soldernerd/UltrasonicAnemometerHardware/StandaloneAnemometer_RevA_BOM.xlsx

Qty | Value | Device | Package | Parts | Description | MF | MPN | OC_FARNELL | OC_NEWARK | Manufacturer | Model | Farnell | Unit Price | Price | Manufacturer | Model | Farnell | Unit Price
1 |  | LED0805 | LED0805 | LED1 | LED |  |  |  |  | Kingbright | KP-2012SECK | 2290332 | 0.115 | 0.115
19 | 100n | CC0805 | C0805 | C5, C6, C7, C8, C9, C10, C11, C12, C13, C14, C15, C16, C20, C21, C22, C23, C24, C25, C26 | Capacitor |  |  |  |  | Multicomp | MC0805B104K500CT | 1759265 | 0.0146 | 0.2774
28 | 10k | RESISTORR0805 | R0805 | R2, R3, R4, R5, R6, R7, R8, R9, R10, R11, R12, R13, R14, R15, R16, R17, R18, R19, R20, R22, R23, R24, R25, R26, R27, R28, R29, R30 | RESISTOR, European symbol |  |  |  |  | Multicomp | MC01W0805110K | 9332391 | 0.0018 | 0.0504
2 | 10p | CC0805 | C0805 | C17, C18 | Capacitor |  |  |  |  |  |  |  | 0.06 | 0.12
4 | 10u 6V3 | CC0805 | C0805 | C2, C3, C4, C19 | Capacitor |  |  |  |  |  |  |  | 0.07 | 0.28
1 | 1k | RESISTORR0805 | R0805 | R21 | RESISTOR, European symbol |  |  |  |  | Multicomp | MC01W080511K | 9332383 | 0.0022 | 0.0022
1 | 330 | RESISTORR0805 | R0805 | R1 | RESISTOR, European symbol |  |  |  |  |  |  |  | 0.02 | 0.02
1 | 33u 16V | C_POLARIZEDSMC_B | SMC_B | C1 |  |  |  |  |  | AVX | TPSB336K016R0350 | 1658966 | 0.673 | 0.673
2 | 74HC4052SO | 74HC4052SO | SO16 | IC1, IC2 |  |  |  |  |  | NXP | 74HC4052D | 1201328 | 0.397 | 0.794
1 | 8MHz | CRYSTAL_SHIELDED | 5X3.2MM | XTAL1 | Shielded Crystal |  |  |  |  | Abracon | ABM3B-8.000MHZ-10-1UT | 2467816 | 0.85 | 0.85 | Abracon | ABM3-8.000MHZ-D2Y-T | 2101329 | 0.527
4 | BSS308PE | P-FET | SOT23 | Q2, Q3, Q4, Q5 |  |  |  |  |  | Infineon | BSS308PE H6327 | 2432719 | 0.1708 | 0.6832
1 | I2C1 | 22-23-2031 | 22-23-2031 | X6 | .100 (2.54mm) Center Header - 3 Pin" | MOLEX | 22-23-2031 | 1462950 | 30C0862
1 | I2C2 | 22-23-2031 | 22-23-2031 | X9 | .100 (2.54mm) Center Header - 3 Pin" | MOLEX | 22-23-2031 | 1462950 | 30C0862
1 | ICSP | 22-23-2051 | 22-23-2051 | X3 | .100 (2.54mm) Center Header - 5 Pin" | MOLEX | 22-23-2051 | 1462952 | 38C9178 |  |  |  | 0.2 | 0.2
1 | Input | 22-23-20411MM | 22-23-2041 | X5 | .100 (2.54mm) Center Header - 4 Pin"
2 | LM5111-2M | LM5111 | SOIC8 | IC3, IC7 | Dual 5A Compound Gate Driver |  |  |  |  | Texas Instruments | LM5111-2M/NOPB | 1685382 | 1.35 | 2.7
1 | LMC6482 | LMC6482 | SOIC8 | IC8 | CMOS Dual Rail-to-Rail Input and Output Operational Amplifier |  |  |  |  | Texas Instruments | LMC6482IM/NOPB | 1468889 | 1.75 | 1.75
1 | MCP1755 | MCP1755 | SOT-23-5 | IC9 |  |  |  |  |  | Microchip | MCP1755T-3302E/OT | 2361992 | 0.52 | 0.52
1 | MCP4561 | MCP4561MSOP | MSOP | IC10 | Digital POT |  |  |  |  | Microchip | MCP4561-103E/MS | 1698948 | 1.02 | 1.02 | Microchip | MCP4531-103E/MS | 1698946 | 0.591
1 | MCP6561R | MCP6561R | SOT-23-5 | IC6 | 1.8V Low-Power Push-Pull Output Comparator |  |  |  |  | Microchip | MCP6561RT-E/OT | 1834857 | 0.496 | 0.496
1 | Output | 22-23-20411MM | 22-23-2041 | X8 | .100 (2.54mm) Center Header - 4 Pin"
1 | PIC32MX2XX | PIC32MX2XX | SO28W | IC5 |  |  |  |  |  | Microchip | PIC32MX250F128B-I/SO | 2097772 | 3.69 | 3.69
1 | Power | 22-23-2021100MIL | 22-23-2021 | X1 | .100 (2.54mm) Center Header - 2 Pin" | MOLEX | 22-23-2021 | 1462926 | 25C3832
1 | SPI | 22-23-2061 | 22-23-2061 | X2 | .100 (2.54mm) Center Header - 6 Pin" | MOLEX | 22-23-2061 | 1462922 | 27C1933
1 | TCM829 | TCM829 | SOT-23-5 | IC4 |  |  |  |  |  | Microchip | TCM829ECT713 | 1840937 | 0.353 | 0.353
1 | Transducers | CON_8X3.5MM | 3.5MM_8X | CON1 | 8-pin header |  |  |  |  |  |  |  |  | 0
1 | USB | 22-23-20411MM | 22-23-2041 | X7 | .100 (2.54mm) Center Header - 4 Pin"
1 | USB_BMULTICOMP | USB_BMULTICOMP | USB_B | X4 | Type B USB connector |  |  |  |  | Multicomp | USB-B-S-RA | 2112373 | 0.566 | 0.566
1 | Board |  |  |  |  |  |  |  |  |  |  |  | 3.75 | 3.75
4 | Transducers |  |  |  |  |  |  |  |  | Multicomp | MCUSD16A40S12RO | 2362677 | 3.75 | 15
 |  |  |  |  |  |  |  |  |  |  |  |  |  | 33.9102
 |  |  |  |  |  |  |  |  |  |  |  |  |  | 36.85891304
