soldernerd/UltrasonicAnemometerHardware/(threads)

Thread 1 (2018-05-29):

Use CADLAB.io to render EAGLE files and diffs online

renne, 2018-05-29:
[CADLAB.io](https://cadlab.io/) is a service which renders EAGLE files and diffs online. This allows to show different stages of circuit/PCB development and improves community-based development.

I suggest to use [CADLAB.io](https://cadlab.io/) for rendering but stay with GitHub for versioning (forks, pull requests, etc.).
