soldernerd/UltrasonicAnemometerHardware/StandaloneAnemometer_RevB_Board.pdf

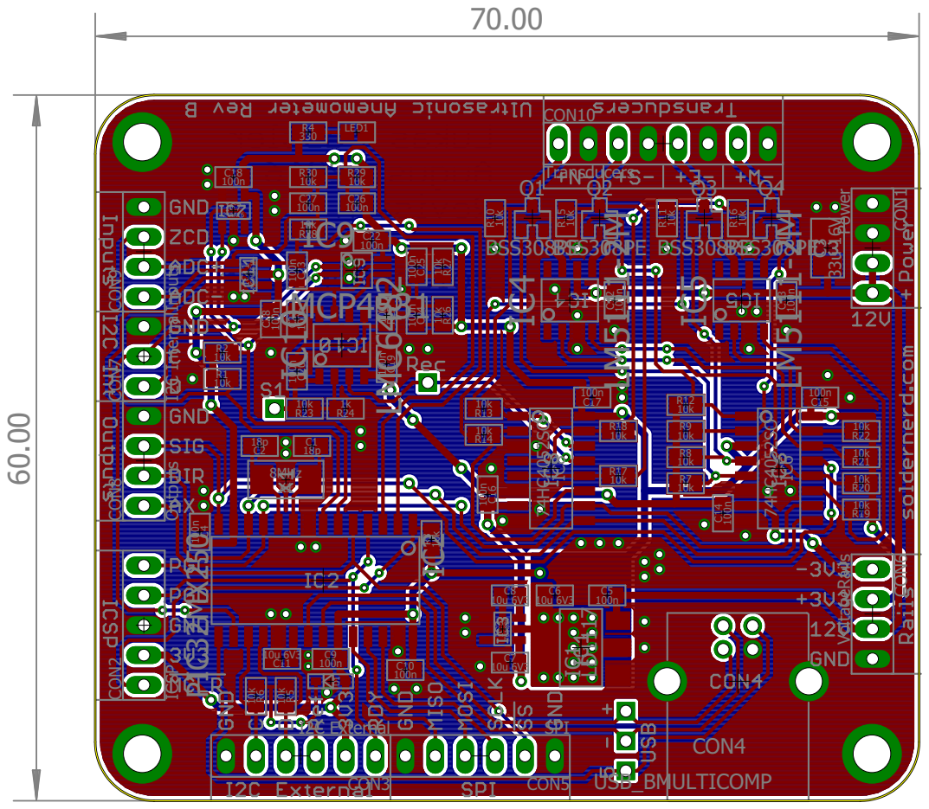
[picture p1: page 1]

IC6 IC4 C3 C8 C6 C7 R4 LED1 C4 C15 C14 IC8 C17 C16 R19 R20 R21 R22 R7R8R9 R12 C12 Q1 Q2 R10 R13 R15 R17 IC5C13 Q3 Q4 R11 R14 R16 R18 IC10 C19 C21 CON10 IC3 CON4 IC R23 C1 C2 C11 C10 C9 R2R1 IC11 R6R5 R23 R24 C22 C25 R26 R27 C24 C20 C27 R30 R29 C26 R25 C28 R28C23 X1 D1IC1 IC7 C18 IC9 C5 CON1 CON9 CON8 CON6 CON7 CON2 CON3 CON5 70.00 60.00 74HC4052SO LM5111-2M 33u 16V 10u 6V3 10u 6V3 10u 6V3 330 100n 100n 100n 74HC4052SO 100n 100n 10k 10k 10k 10k 10k 10k 10k 10k 100n BSS308BPSES308PE 10k 10k 10k 10k LM5111-2M 100n BSS308BPSES308PE 10k 10k 10k 10k LMC6482 100n 100n Transducers TCM829 USB_BMULTICOMP PIC32MX25010k 18p 18p10u 6V3 100n 100n 10k 10k MCP6561R 10k 10k 10k 1k 100n 100n 10k 10k 100n 100n 100n 10k 10k 100n 10k 100n 10k 100n 8MHz LD1117 24AA16 100n MCP4531 100n Power Inputs Outputs VoltageRails I2C Internal ICSP I2C External SPI
