soldernerd/UltrasonicAnemometerHardware/StandaloneAnemometer_RevB_Schematic.pdf

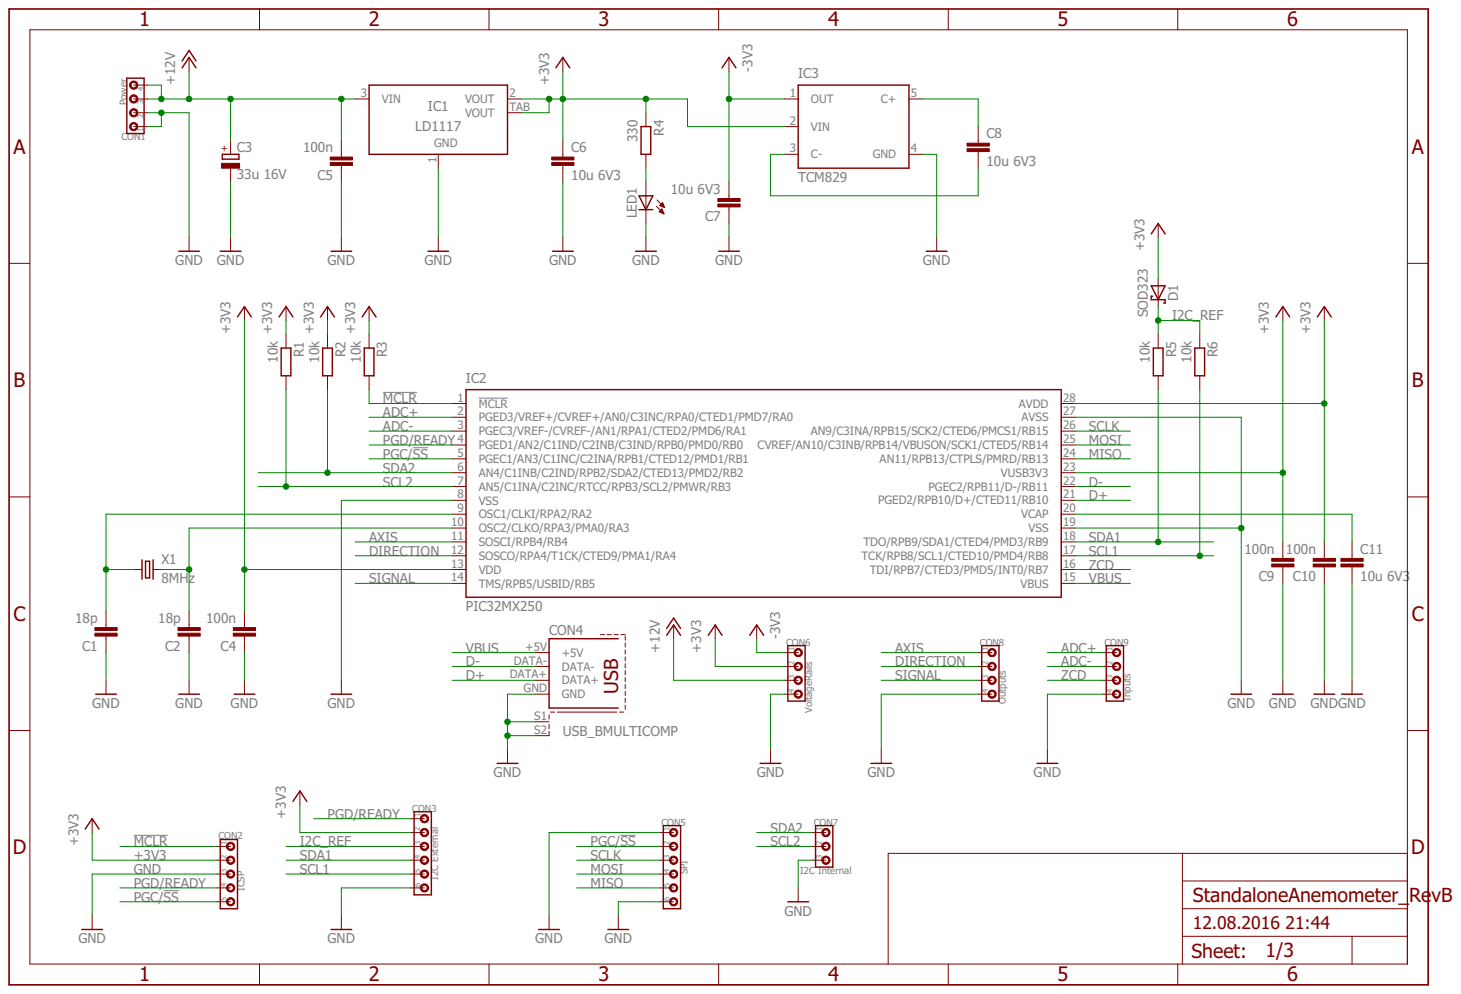
[picture p2: page 1]

11 DIRECTION 12 13

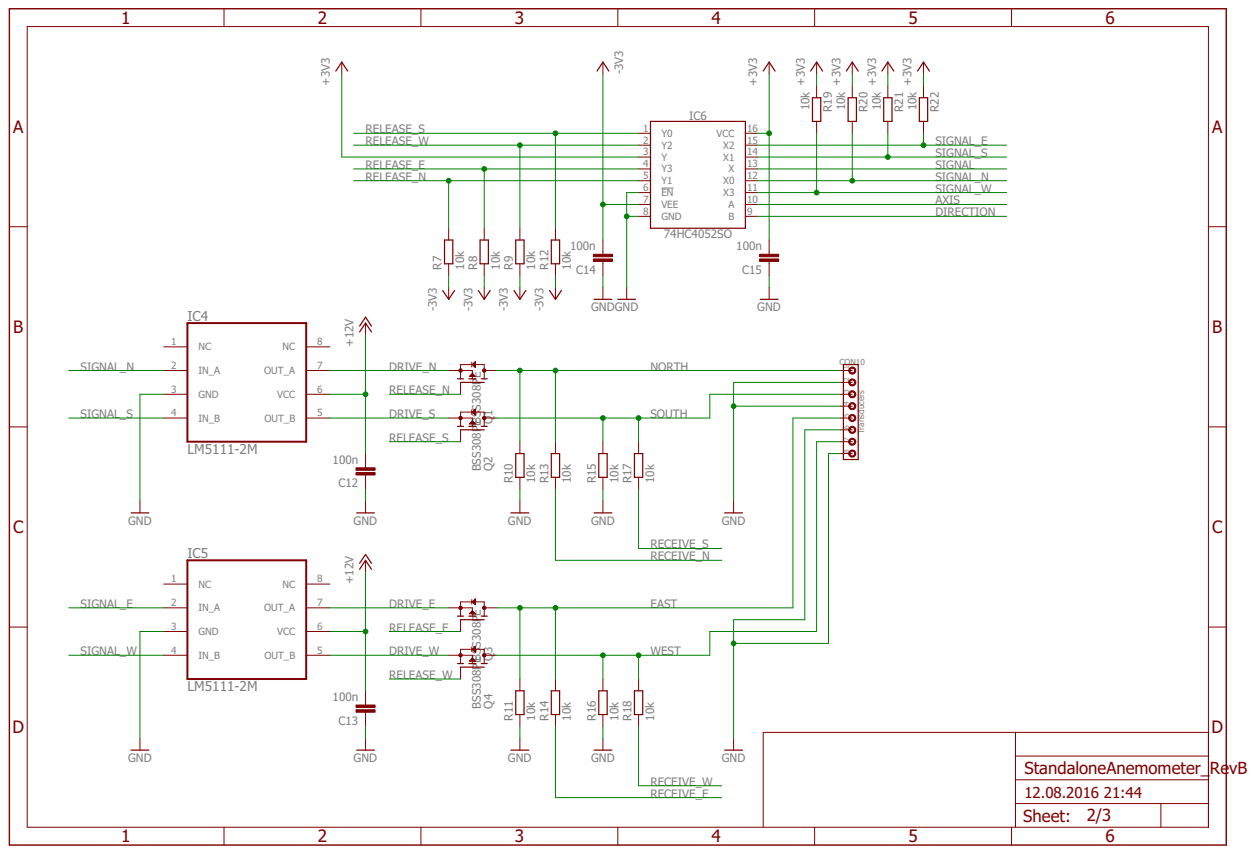
[picture p3: page 2]

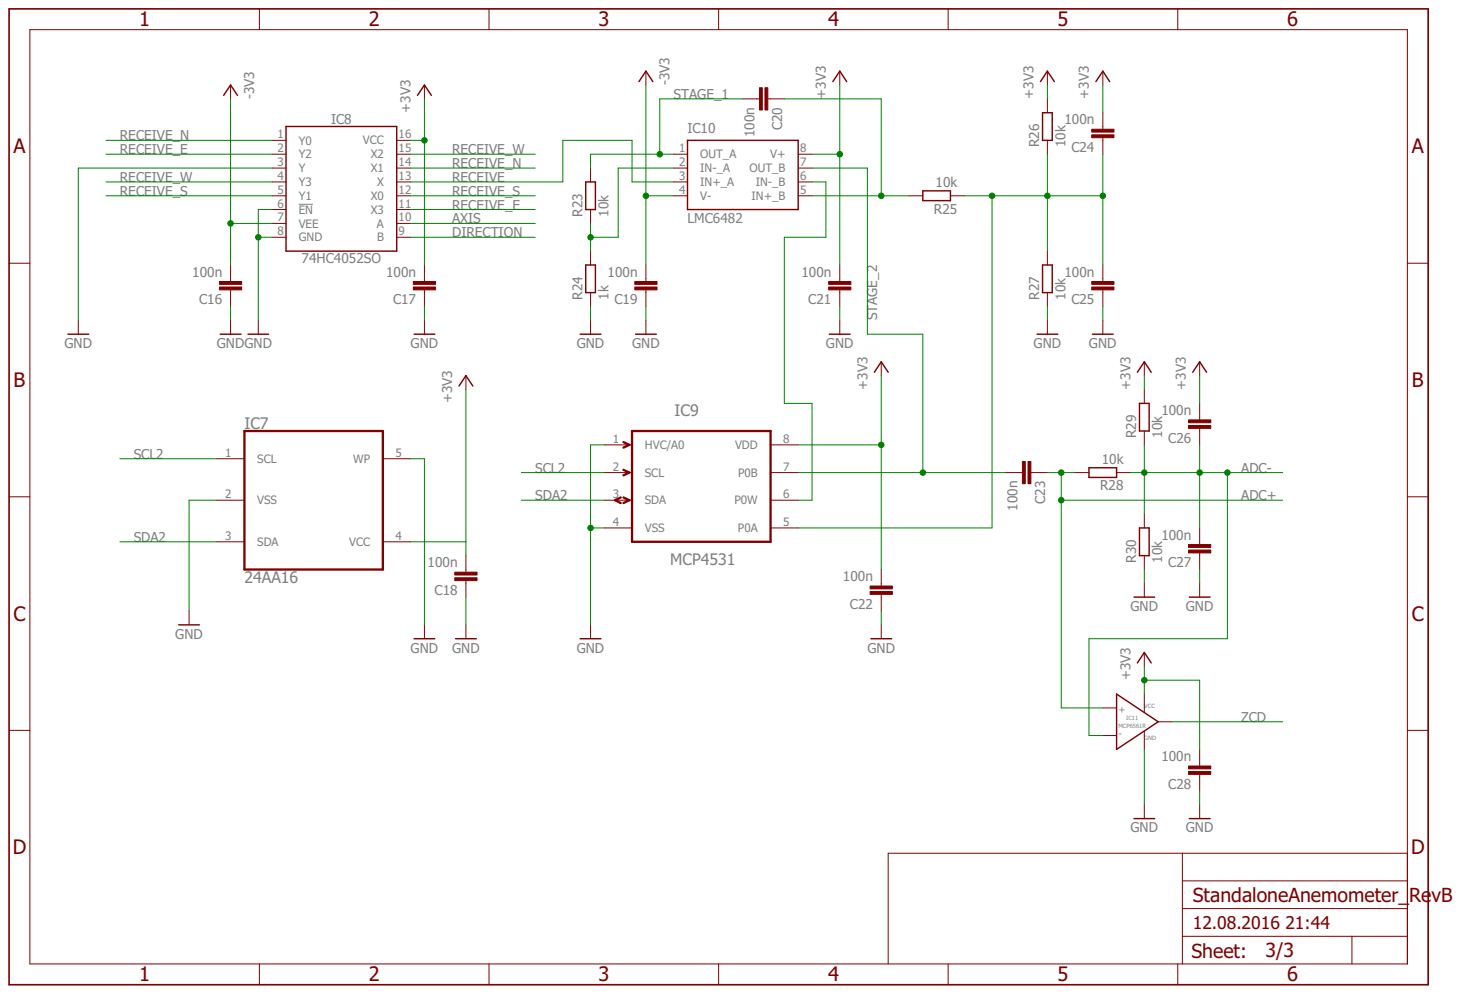
[picture p4: page 3]
