soldernerd/UltrasonicAnemometerHardware/StandaloneAnemometer_RevA_schematic.pdf

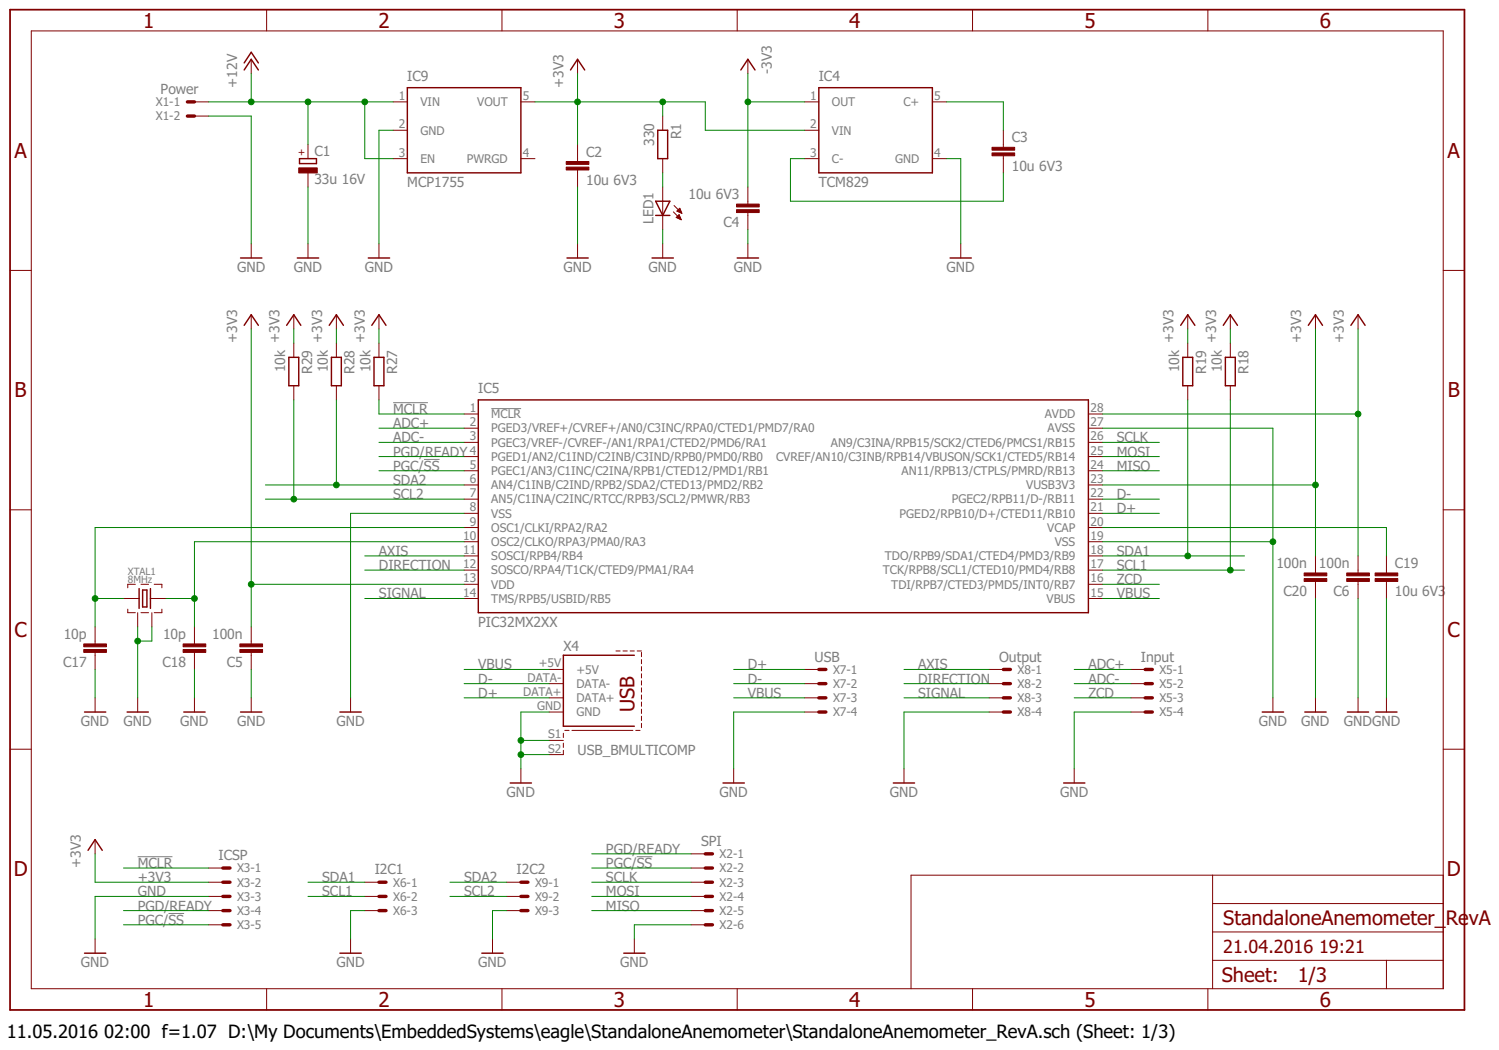
[picture p5: page 1]

AXIS 11

11.05.2016 02:00 f=1.07 D:\My Documents\EmbeddedSystems\eagle\StandaloneAnemometer\StandaloneAnemometer_RevA.sch (Sheet: 1/3)

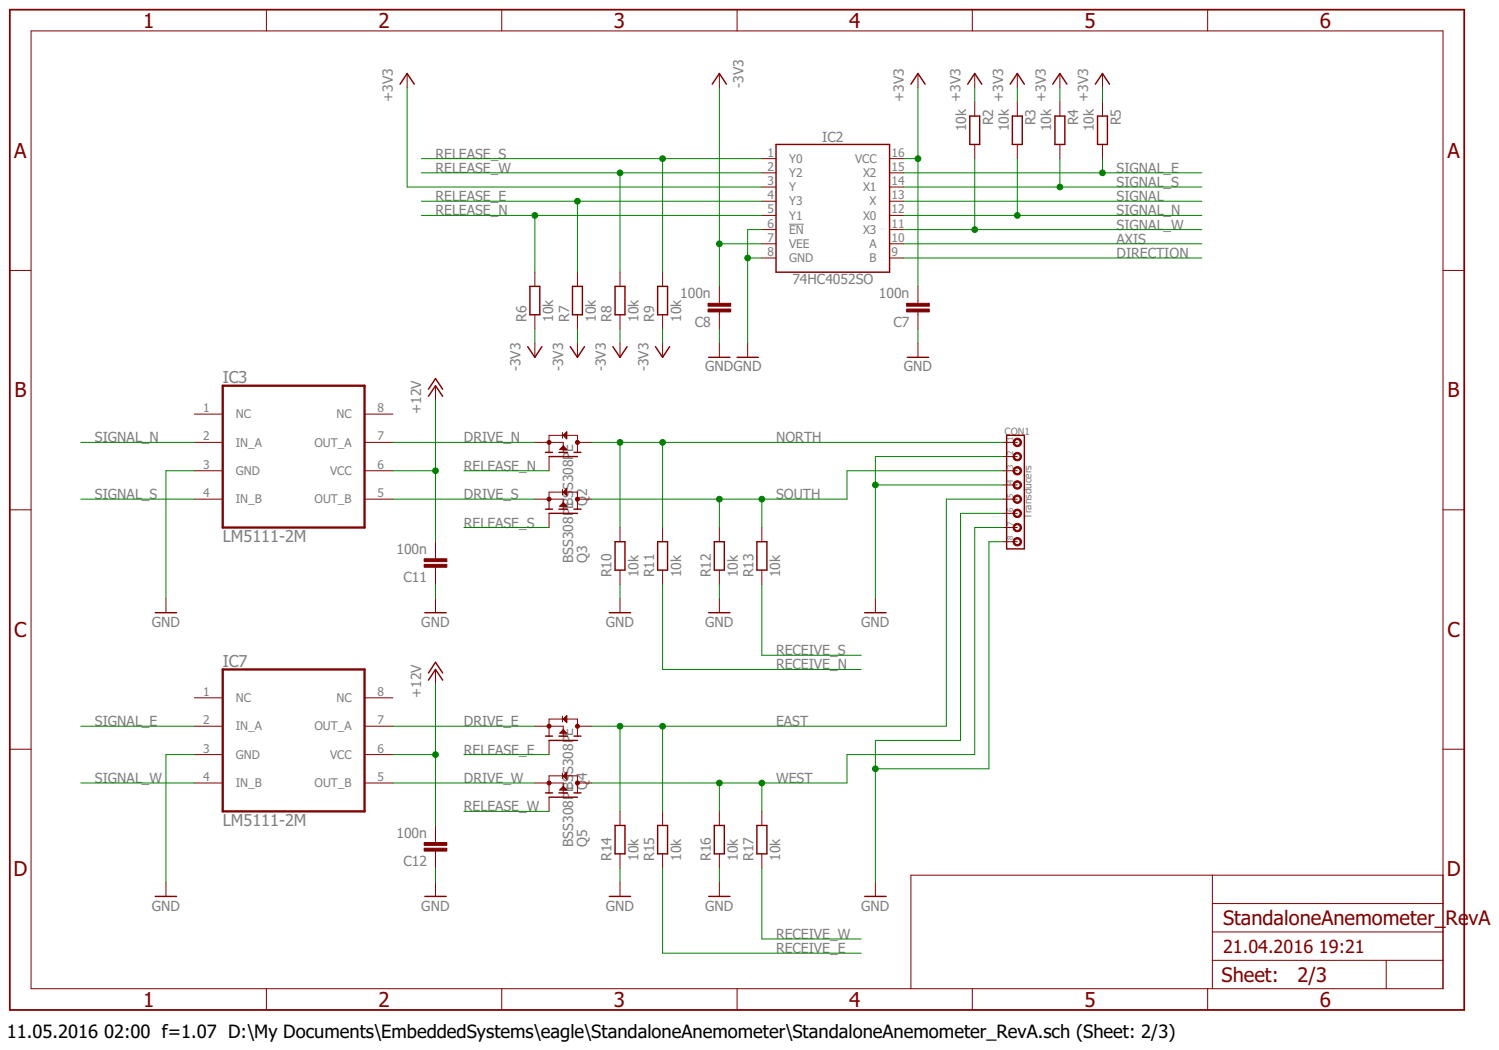
[picture p6: page 2]

11.05.2016 02:00 f=1.07 D:\My Documents\EmbeddedSystems\eagle\StandaloneAnemometer\StandaloneAnemometer_RevA.sch (Sheet: 2/3)

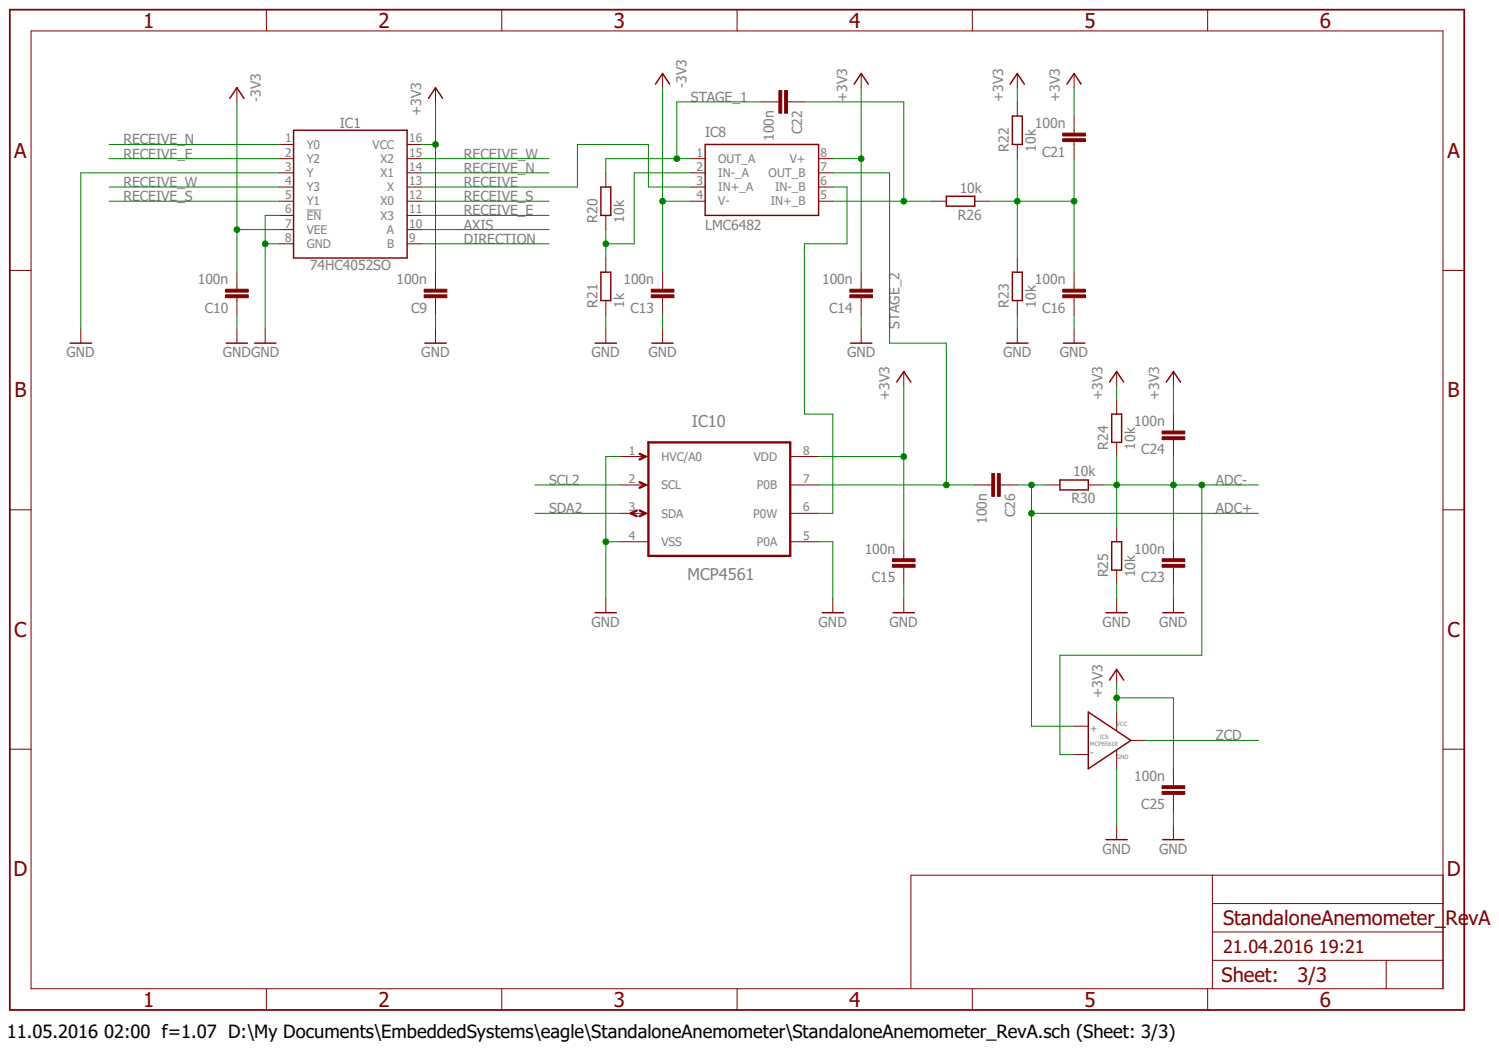
[picture p7: page 3]

3 | SCL 2 | 7

11.05.2016 02:00 f=1.07 D:\My Documents\EmbeddedSystems\eagle\StandaloneAnemometer\StandaloneAnemometer_RevA.sch (Sheet: 3/3)
