soldernerd/UltrasonicAnemometerHardware/StandaloneAnemometer_RevA_board.pdf

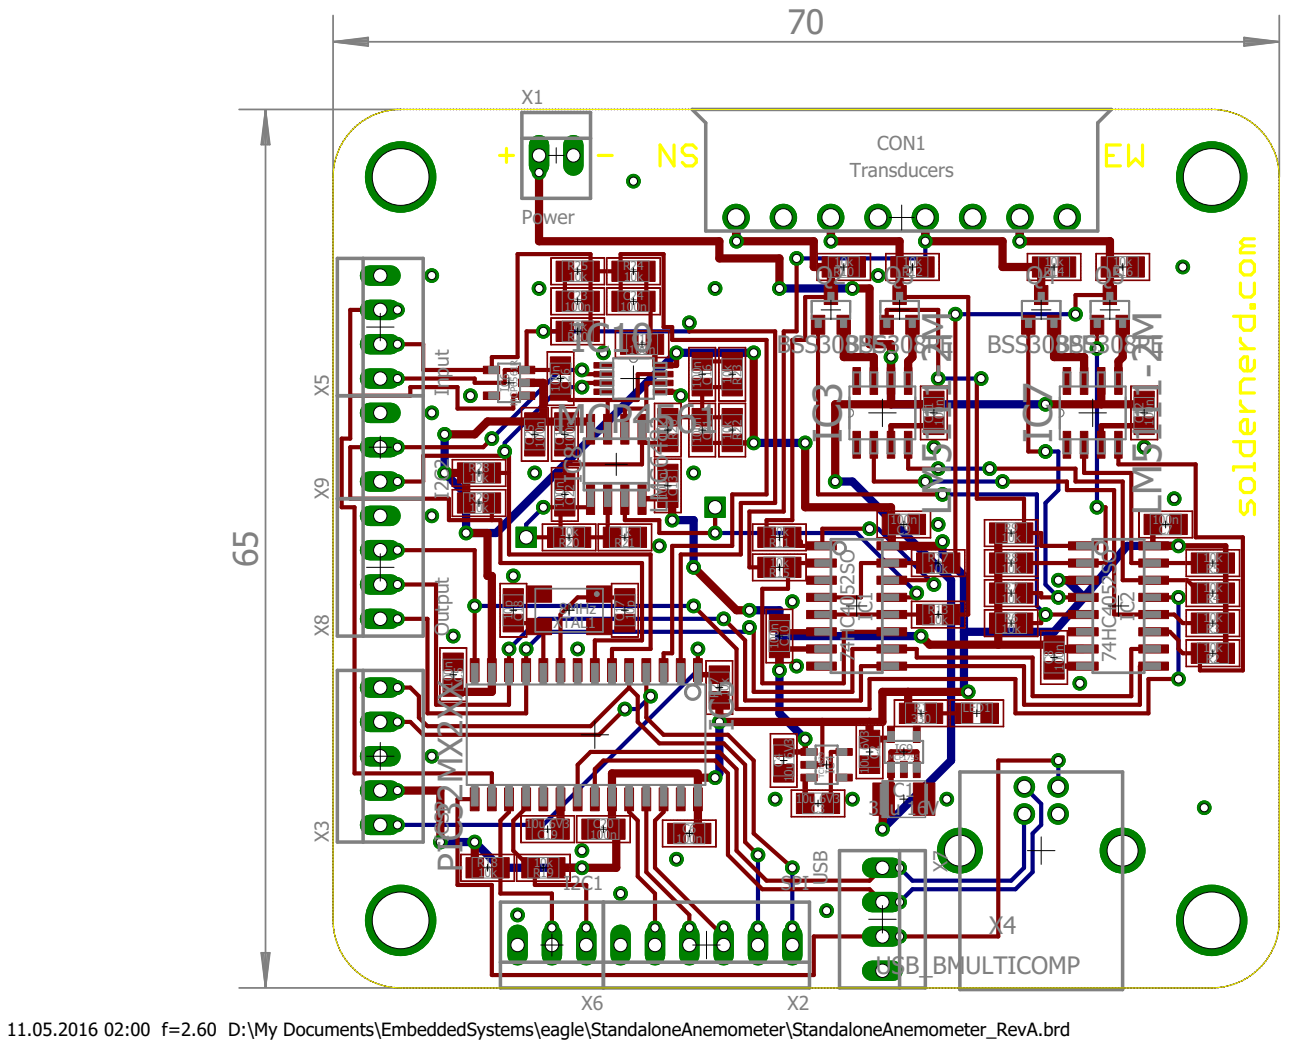
[picture p8: page 1]

BSS308BPSES308PE

11.05.2016 02:00 f=2.60 D:\My Documents\EmbeddedSystems\eagle\StandaloneAnemometer\StandaloneAnemometer_RevA.brd
