soldernerd/UltrasonicAnemometerHardware/StandaloneAnemometer_RevB.brd

## EAGLE design StandaloneAnemometer_RevB.brd (2017-01-07)

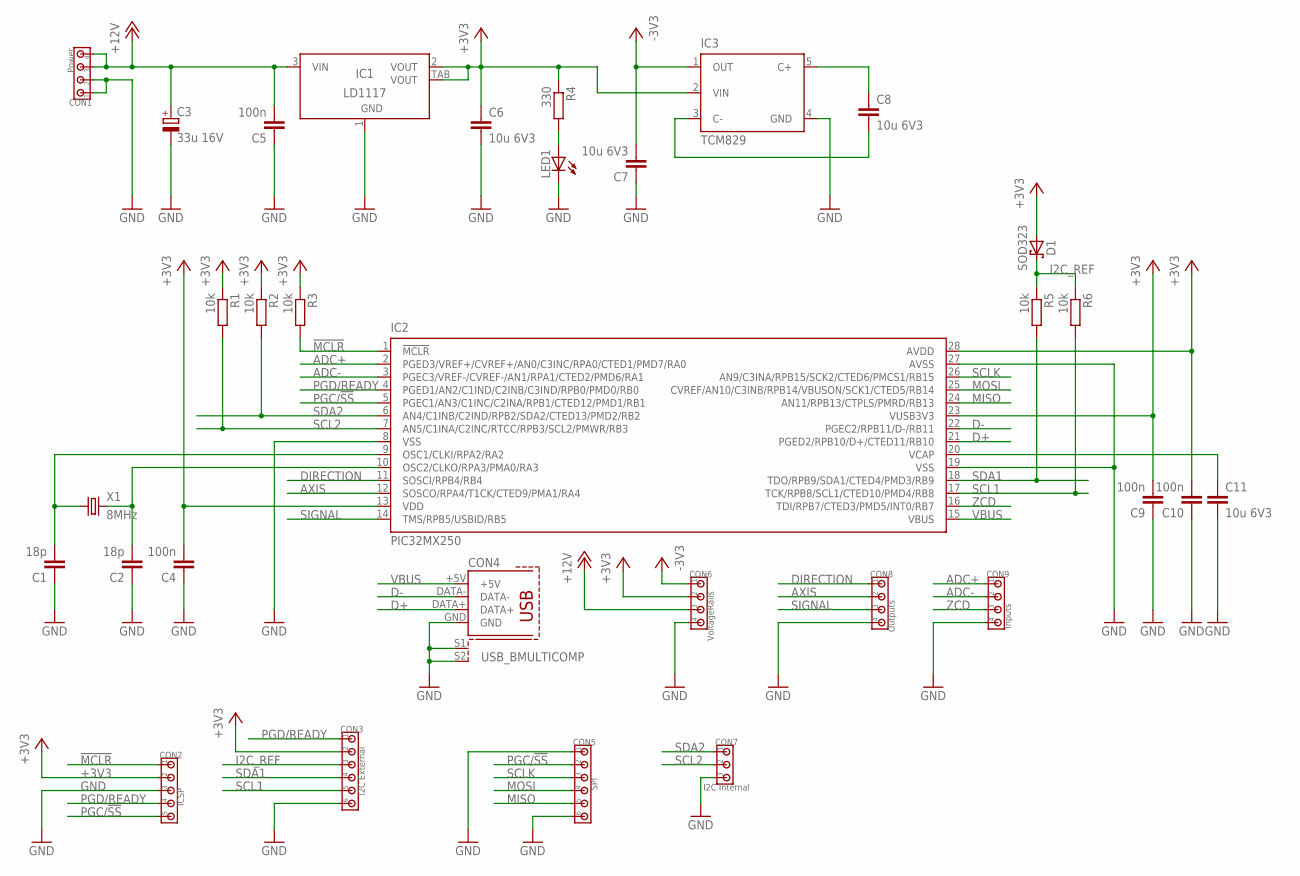
[picture p9: schematic StandaloneAnemometer_RevB.sch, sheet 1]

Parts:
C1, C2: 18p; C0805
C3: 33u 16V; SMC_B
C4, C5, C9, C10: 100n; C0805
C6, C7, C8, C11: 10u 6V3; C0805
CON1: Power; 100MIL_4X
CON2: ICSP; 100MIL_5X
CON3: I2C External; 100MIL_6X
CON4: USB_BMULTICOMP; USB_B
CON5: SPI; 100MIL_6X
CON6: VoltageRails; 100MIL_4X
CON7: I2C Internal; 100MIL_3X
CON8: Outputs; 100MIL_4X
CON9: Inputs; 100MIL_4X
D1: SOD323
IC1: LD1117; SOT223
IC2: PIC32MX250; SO28W
IC3: TCM829; SOT-23-5
LED1: LED0805
R1, R2, R3, R5, R6: 10k; R0805
R4: 330; R0805
X1: 8MHz; 5X3.2MM

Connections:
!MCLR!: CON2.1, IC2.1 (!MCLR!), R3.2
+3V3: C4.2, C6.1, C9.2, C10.2, CON2.2, CON3.2, CON6.2, D1.A, IC1.2 (VOUT), IC1.TAB (VOUT), IC2.13 (VDD), IC2.23 (VUSB3V3), IC2.28 (AVDD), IC3.2 (VIN), R1.1, R2.1, R3.1, R4.1; also elsewhere on the board
+12V: C3.+, C5.2, CON1.3, CON1.4, CON6.3, IC1.3 (VIN); also elsewhere on the board
-3V3: C7.2, CON6.1, IC3.1 (OUT); also elsewhere on the board
ADC+: CON9.1, IC2.2 (PGED3/VREF+/CVREF+/AN0/C3INC/RPA0/CTED1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); also elsewhere on the board
ADC-: CON9.2, IC2.3 (PGEC3/VREF-/CVREF-/AN1/RPA1/CTED2/PMD6/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); also elsewhere on the board
AXIS: CON8.2, IC2.12 (SOSCO/RPA4/T1CK/CTED9/PMA1/RA4); also elsewhere on the board
D+: CON4.DATA+, IC2.21 (PGED2/RPB10/D+/CTED11/RB10)
D-: CON4.DATA-, IC2.22 (PGEC2/RPB11/D-/RB11)
DIRECTION: CON8.1, IC2.11 (SOSCI/RPB4/RB4); also elsewhere on the board
GND: C1.1, C2.1, C3.-, C4.1, C5.1, C6.2, C7.1, C9.1, C10.1, C11.2, CON1.1, CON1.2, CON2.3, CON3.6, CON4.GND, CON4.S1, CON4.S2, CON5.1, CON5.6, CON6.4, CON7.3, CON8.4, CON9.4, IC1.1 (GND), IC2.8 (VSS), IC2.19 (VSS), IC2.27 (AVSS), IC3.4 (GND), LED1.C; also elsewhere on the board
I2C_REF: CON3.3, D1.C, R5.1, R6.1
MISO: CON5.5, IC2.24 (AN11/RPB13/CTPLS/PMRD/RB13)
MOSI: CON5.4, IC2.25 (CVREF/AN10/C3INB/RPB14/VBUSON/SCK1/CTED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)
unnamed: LED1.A, R4.2
unnamed: C8.2, IC3.3 (C-)
unnamed: C8.1, IC3.5 (C+)
unnamed: C1.2, IC2.9 (OSC1/CLKI/RPA2/RA2), X1.1
unnamed: C2.2, IC2.10 (OSC2/CLKO/RPA3/PMA0/RA3), X1.2
unnamed: C11.1, IC2.20 (VCAP)
PGC/!SS!: CON2.5, CON5.2, IC2.5 (PGEC1/AN3/C1INC/C2INA/RPB1/CTED12/PMD1/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)
PGD/READY: CON2.4, CON3.1, IC2.4 (PGED1/AN2/C1IND/C2INB/C3IND/RPB0/PMD0/R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)
SCL1: CON3.5, IC2.17 (TCK/RPB8/SCL1/CTED10/PMD4/RB8), R6.2
SCL2: CON7.2, IC2.7 (AN5/C1INA/C2INC/RTCC/RPB3/SCL2/PMWR/RB3), R1.2; also elsewhere on the board
SCLK: CON5.3, IC2.26 (AN9/C3INA/RPB15/SCK2/CTED6/PMCS1/RB15)
SDA1: CON3.4, IC2.18 (TDO/RPB9/SDA1/CTED4/PMD3/RB9), R5.2
SDA2: CON7.1, IC2.6 (AN4/C1INB/C2IND/RPB2/SDA2/CTED13/PMD2/R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), R2.2; also elsewhere on the board
SIGNAL: CON8.3, IC2.14 (TMS/RPB5/USBID/RB5); also elsewhere on the board
VBUS: CON4.+5V, IC2.15 (VBUS)
ZCD: CON9.3, IC2.16 (TDI/RPB7/CTED3/PMD5/INT0/RB7); also elsewhere on the board

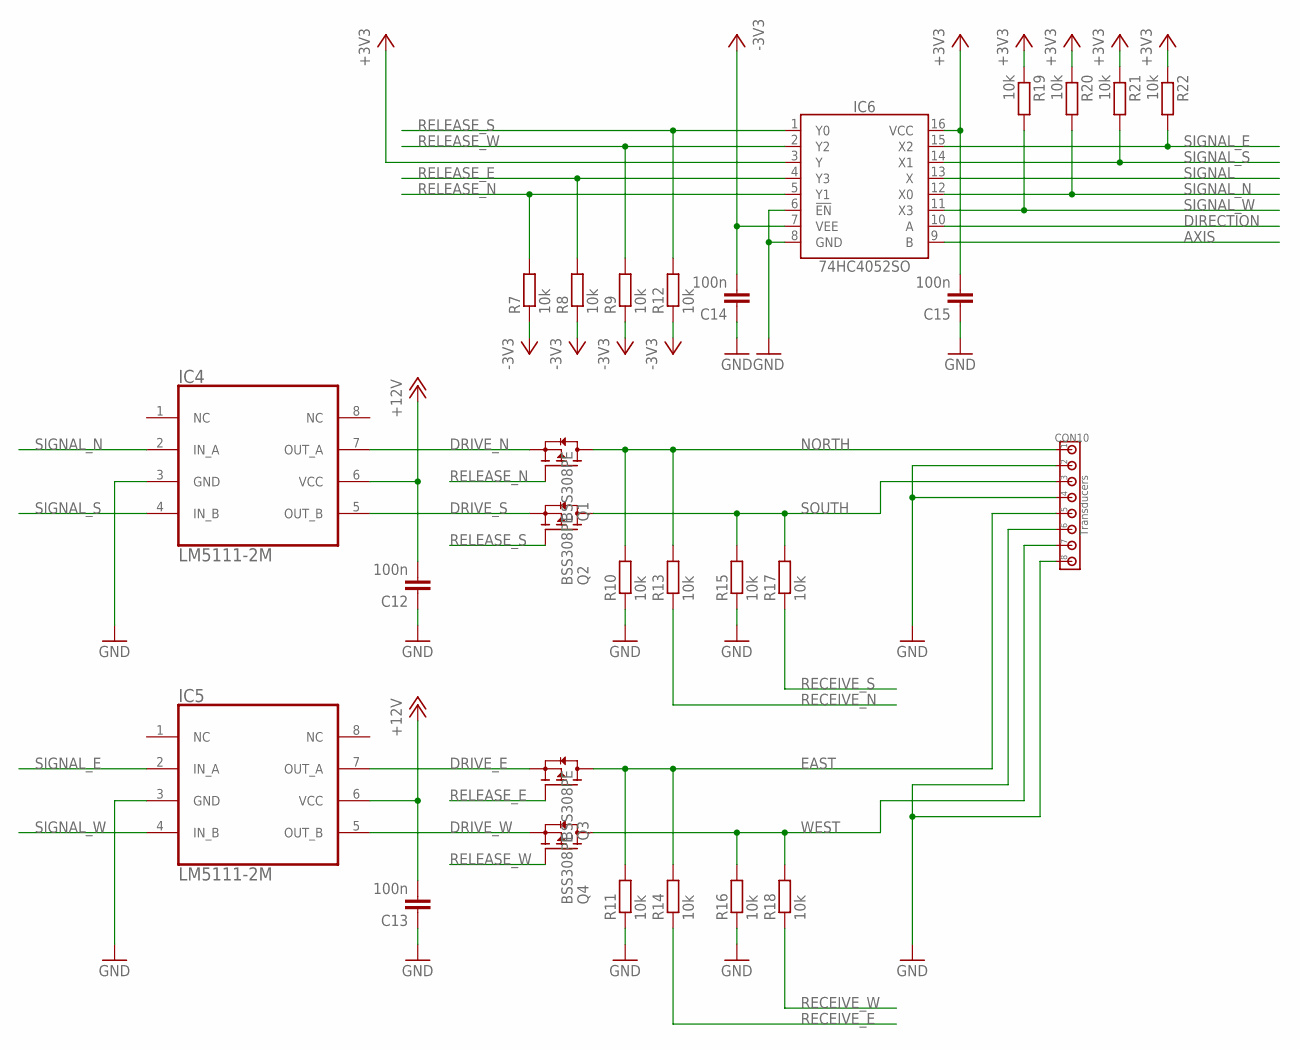
[picture p10: schematic StandaloneAnemometer_RevB.sch, sheet 2]

Parts:
C12, C13, C14, C15: 100n; C0805
CON10: Transducers; 100MIL_8X
IC4, IC5: LM5111-2M; SOIC8
IC6: 74HC4052SO; SO16
Q1, Q2, Q3, Q4: BSS308PE; SOT23
R7, R8, R9, R10, R11, R12, R13, R14, R15, R16, R17, R18, R19, R20, R21, R22: 10k; R0805

Connections:
+3V3: C15.2, IC6.3 (Y), IC6.16 (VCC), R19.1, R20.1, R21.1, R22.1; also elsewhere on the board
+12V: C12.2, C13.2, IC4.6 (VCC), IC5.6 (VCC); also elsewhere on the board
-3V3: C14.2, IC6.7 (VEE), R7.1, R8.1, R9.1, R12.1; also elsewhere on the board
AXIS: IC6.9 (B); also elsewhere on the board
DIRECTION: IC6.10 (A); also elsewhere on the board
DRIVE_E: IC5.7 (OUT_A), Q3.2 (S)
DRIVE_N: IC4.7 (OUT_A), Q1.2 (S)
DRIVE_S: IC4.5 (OUT_B), Q2.2 (S)
DRIVE_W: IC5.5 (OUT_B), Q4.2 (S)
EAST: CON10.5, Q3.3 (D), R11.2, R14.2
GND: C12.1, C13.1, C14.1, C15.1, CON10.2, CON10.4, CON10.6, CON10.8, IC4.3 (GND), IC5.3 (GND), IC6.6 (!EN!), IC6.8 (GND), R10.1, R11.1, R15.1, R16.1; also elsewhere on the board
NORTH: CON10.1, Q1.3 (D), R10.2, R13.2
RECEIVE_E: R14.1; also elsewhere on the board
RECEIVE_N: R13.1; also elsewhere on the board
RECEIVE_S: R17.1; also elsewhere on the board
RECEIVE_W: R18.1; also elsewhere on the board
RELEASE_E: IC6.4 (Y3), Q3.1 (G), R8.2
RELEASE_N: IC6.5 (Y1), Q1.1 (G), R7.2
RELEASE_S: IC6.1 (Y0), Q2.1 (G), R12.2
RELEASE_W: IC6.2 (Y2), Q4.1 (G), R9.2
SIGNAL: IC6.13 (X); also elsewhere on the board
SIGNAL_E: IC5.2 (IN_A), IC6.15 (X2), R22.2
SIGNAL_N: IC4.2 (IN_A), IC6.12 (X0), R20.2
SIGNAL_S: IC4.4 (IN_B), IC6.14 (X1), R21.2
SIGNAL_W: IC5.4 (IN_B), IC6.11 (X3), R19.2
SOUTH: CON10.3, Q2.3 (D), R15.2, R17.2
WEST: CON10.7, Q4.3 (D), R16.2, R18.2

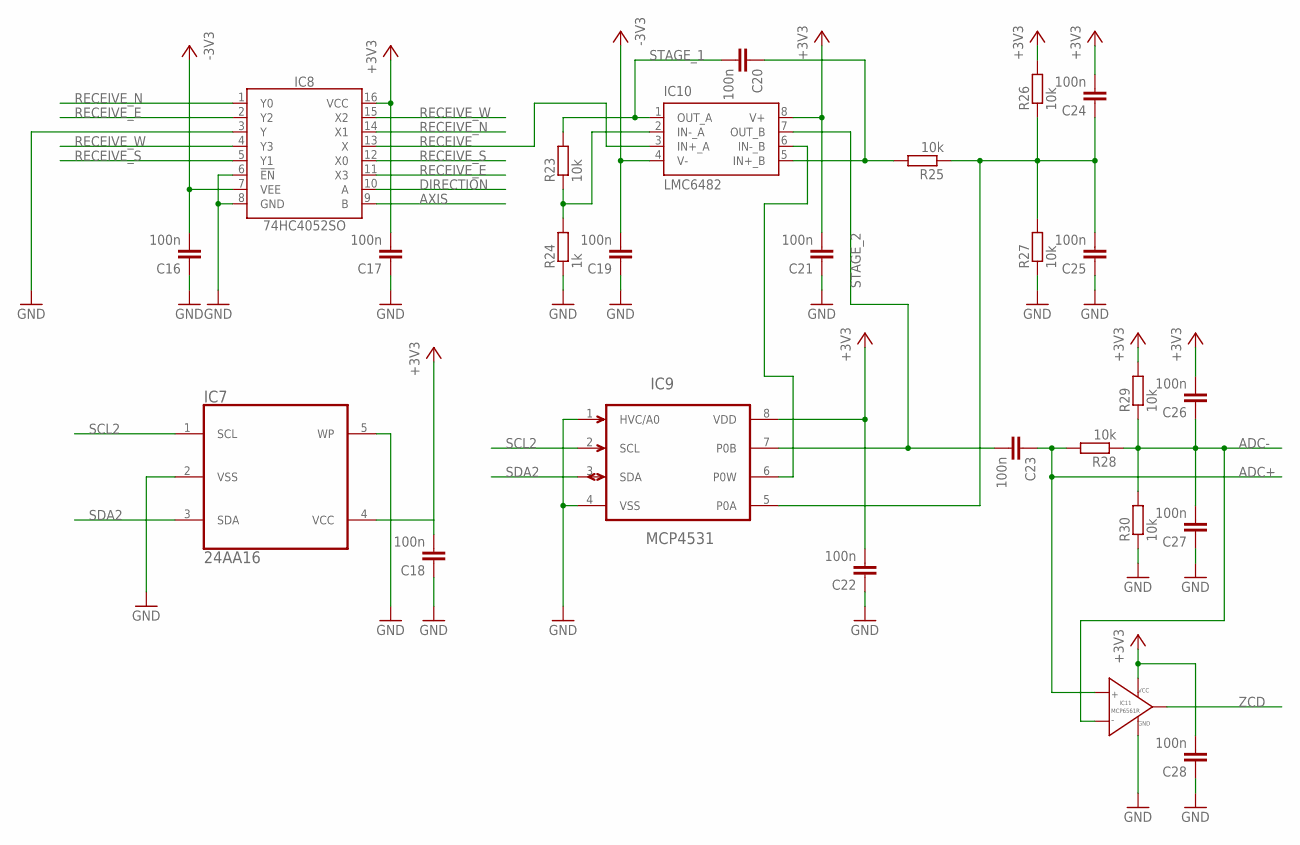
[picture p11: schematic StandaloneAnemometer_RevB.sch, sheet 3]

Parts:
C16, C17, C18, C19, C20, C21, C22, C23, C24, C25, C26, C27, C28: 100n; C0805
IC7: 24AA16; SOT-23-5
IC8: 74HC4052SO; SO16
IC9: MCP4531; MSOP
IC10: LMC6482; SOIC8
IC11: MCP6561R; SOT-23-5
R23, R25, R26, R27, R28, R29, R30: 10k; R0805
R24: 1k; R0805

Connections:
+3V3: C17.2, C18.2, C21.2, C22.2, C24.2, C26.2, C28.2, IC7.4 (VCC), IC8.16 (VCC), IC9.8 (VDD), IC10.8 (V+), IC11.2 (VCC), R26.2, R29.2; also elsewhere on the board
-3V3: C16.2, C19.2, IC8.7 (VEE), IC10.4 (V-); also elsewhere on the board
ADC+: C23.1, IC11.3 (VIN+), R28.2; also elsewhere on the board
ADC-: C26.1, C27.2, IC11.4 (VIN-), R28.1, R29.1, R30.2; also elsewhere on the board
AXIS: IC8.9 (B); also elsewhere on the board
DIRECTION: IC8.10 (A); also elsewhere on the board
FB1: IC10.2 (IN-_A), R23.1, R24.2
FB2: IC9.6 (P0W), IC10.6 (IN-_B)
GND: C16.1, C17.1, C18.1, C19.1, C21.1, C22.1, C25.1, C27.1, C28.1, IC7.2 (VSS), IC7.5 (WP), IC8.3 (Y), IC8.6 (!EN!), IC8.8 (GND), IC9.1 (HVC/A0), IC9.4 (VSS), IC11.5 (GND), R24.1, R27.1, R30.1; also elsewhere on the board
unnamed: C24.1, C25.2, IC9.5 (P0A), R25.1, R26.1, R27.2
RECEIVE: IC8.13 (X), IC10.3 (IN+_A)
RECEIVE_E: IC8.2 (Y2), IC8.11 (X3); also elsewhere on the board
RECEIVE_N: IC8.1 (Y0), IC8.14 (X1); also elsewhere on the board
RECEIVE_S: IC8.5 (Y1), IC8.12 (X0); also elsewhere on the board
RECEIVE_W: IC8.4 (Y3), IC8.15 (X2); also elsewhere on the board
SCL2: IC7.1 (SCL), IC9.2 (SCL); also elsewhere on the board
SDA2: IC7.3 (SDA), IC9.3 (SDA); also elsewhere on the board
STAGE2_IN: C20.1, IC10.5 (IN+_B), R25.2
STAGE_1: C20.2, IC10.1 (OUT_A), R23.2
STAGE_2: C23.2, IC9.7 (P0B), IC10.7 (OUT_B)
ZCD: IC11.1 (VOUT); also elsewhere on the board

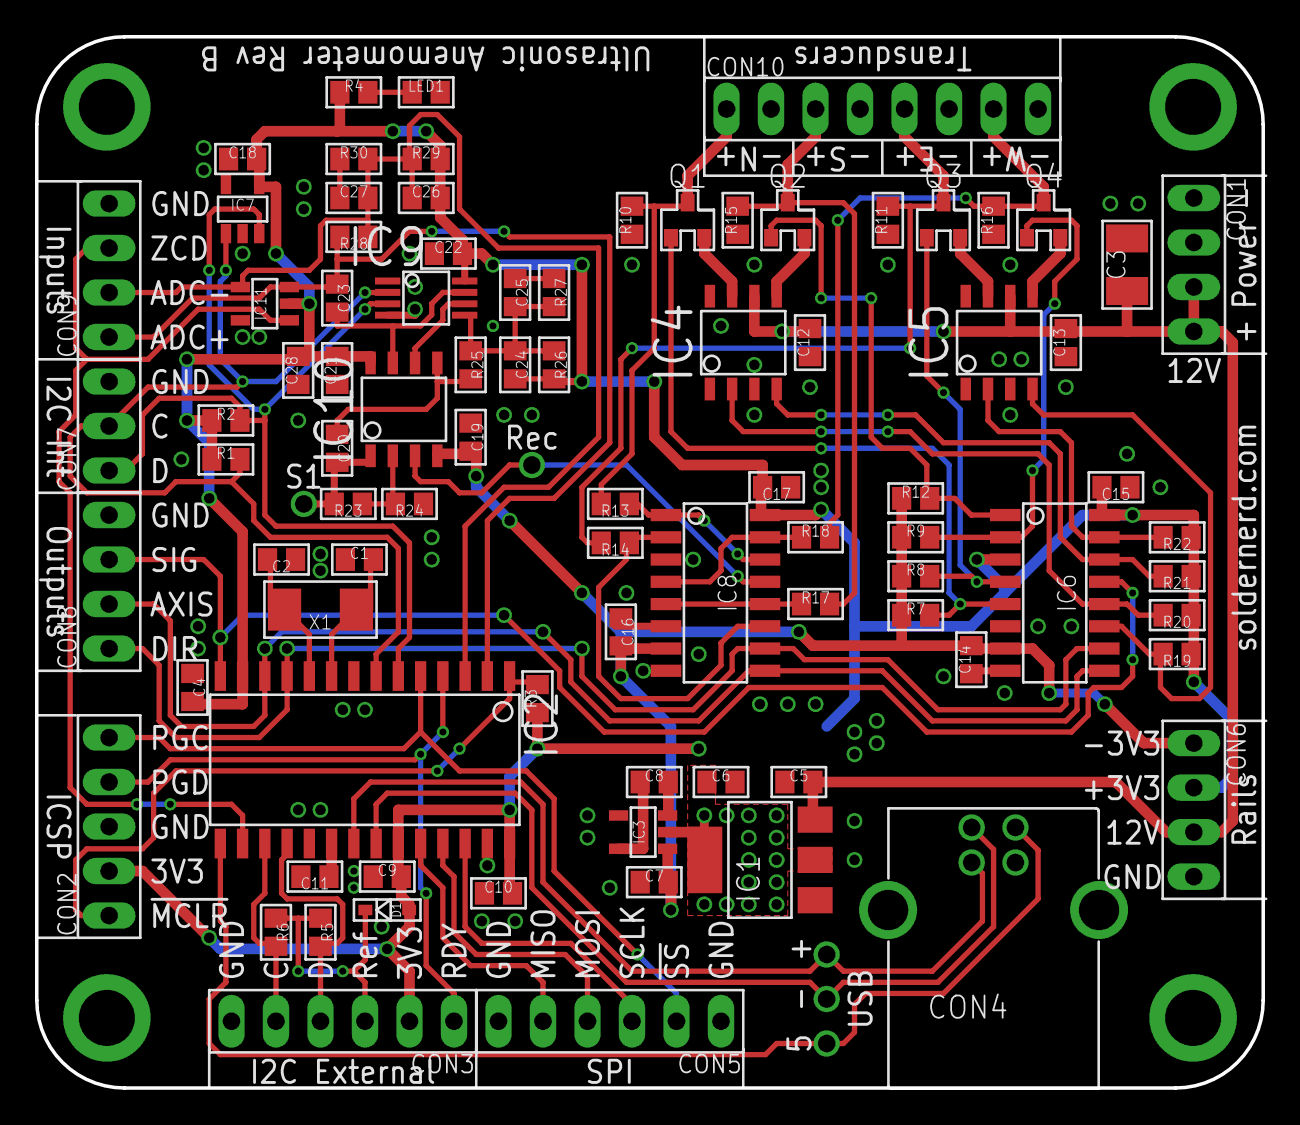
[picture p12: board StandaloneAnemometer_RevB.brd from above]

Board: 2 copper layers, 70.0 x 60.0 mm, 86 parts (0 on the bottom side), 57 nets.
