soldernerd/UltrasonicAnemometerHardware/StandaloneAnemometer_RevA.brd

## EAGLE design StandaloneAnemometer_RevA.brd (2017-01-07, an earlier design)

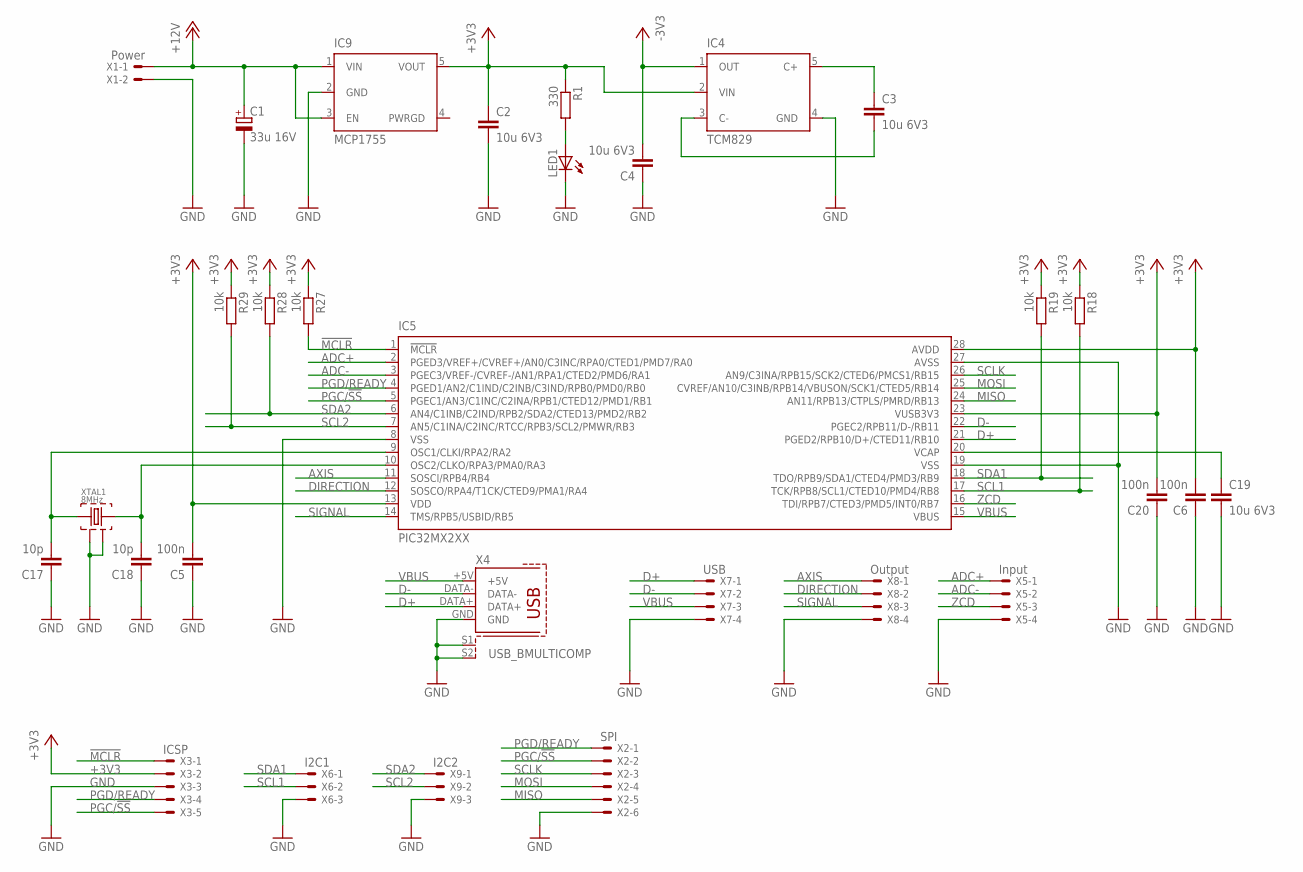
[picture p13: schematic StandaloneAnemometer_RevA.sch, sheet 1]

Parts:
C1: 33u 16V; SMC_B
C2, C3, C4, C19: 10u 6V3; C0805
C5, C6, C20: 100n; C0805
C17, C18: 10p; C0805
IC4: TCM829; SOT-23-5
IC5: PIC32MX2XX; SO28W
IC9: MCP1755; SOT-23-5
LED1: LED0805
R1: 330; R0805
R18, R19, R27, R28, R29: 10k; R0805
X1: Power; 22-23-2021
X2: SPI; 22-23-2061
X3: ICSP; 22-23-2051
X4: USB_BMULTICOMP; USB_B
X5: Input; 22-23-2041
X6: I2C1; 22-23-2031
X7: USB; 22-23-2041
X8: Output; 22-23-2041
X9: I2C2; 22-23-2031
XTAL1: 8MHz; 5X3.2MM

Connections:
!MCLR!: IC5.1 (!MCLR!), R27.2, X3.1
+3V3: C2.1, C5.2, C6.2, C20.2, IC4.2 (VIN), IC5.13 (VDD), IC5.23 (VUSB3V3), IC5.28 (AVDD), IC9.5 (VOUT), R1.1, R18.1, R19.1, R27.1, R28.1, R29.1, X3.2; also elsewhere on the board
+12V: C1.+, IC9.1 (VIN), IC9.3 (EN), X1.1; also elsewhere on the board
-3V3: C4.2, IC4.1 (OUT); also elsewhere on the board
ADC+: IC5.2 (PGED3/VREF+/CVREF+/AN0/C3INC/RPA0/CTED1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), X5.1; also elsewhere on the board
ADC-: IC5.3 (PGEC3/VREF-/CVREF-/AN1/RPA1/CTED2/PMD6/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), X5.2; also elsewhere on the board
AXIS: IC5.11 (SOSCI/RPB4/RB4), X8.1; also elsewhere on the board
D+: IC5.21 (PGED2/RPB10/D+/CTED11/RB10), X4.DATA+, X7.1
D-: IC5.22 (PGEC2/RPB11/D-/RB11), X4.DATA-, X7.2
DIRECTION: IC5.12 (SOSCO/RPA4/T1CK/CTED9/PMA1/RA4), X8.2; also elsewhere on the board
GND: C1.-, C2.2, C4.1, C5.1, C6.1, C17.1, C18.1, C19.2, C20.1, IC4.4 (GND), IC5.8 (VSS), IC5.19 (VSS), IC5.27 (AVSS), IC9.2 (GND), LED1.C, X1.2, X2.6, X3.3, X4.GND, X4.S1, X4.S2, X5.4, X6.3, X7.4, X8.4, X9.3, XTAL1.2, XTAL1.4; also elsewhere on the board
MISO: IC5.24 (AN11/RPB13/CTPLS/PMRD/RB13), X2.5
MOSI: IC5.25 (CVREF/AN10/C3INB/RPB14/VBUSON/SCK1/CTED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), X2.4
unnamed: LED1.A, R1.2
unnamed: C3.2, IC4.3 (C-)
unnamed: C3.1, IC4.5 (C+)
unnamed: C17.2, IC5.9 (OSC1/CLKI/RPA2/RA2), XTAL1.1
unnamed: C18.2, IC5.10 (OSC2/CLKO/RPA3/PMA0/RA3), XTAL1.3
unnamed: C19.1, IC5.20 (VCAP)
PGC/!SS!: IC5.5 (PGEC1/AN3/C1INC/C2INA/RPB1/CTED12/PMD1/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), X2.2, X3.5
PGD/READY: IC5.4 (PGED1/AN2/C1IND/C2INB/C3IND/RPB0/PMD0/R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), X2.1, X3.4
SCL1: IC5.17 (TCK/RPB8/SCL1/CTED10/PMD4/RB8), R18.2, X6.2
SCL2: IC5.7 (AN5/C1INA/C2INC/RTCC/RPB3/SCL2/PMWR/RB3), R29.2, X9.2; also elsewhere on the board
SCLK: IC5.26 (AN9/C3INA/RPB15/SCK2/CTED6/PMCS1/RB15), X2.3
SDA1: IC5.18 (TDO/RPB9/SDA1/CTED4/PMD3/RB9), R19.2, X6.1
SDA2: IC5.6 (AN4/C1INB/C2IND/RPB2/SDA2/CTED13/PMD2/R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), R28.2, X9.1; also elsewhere on the board
SIGNAL: IC5.14 (TMS/RPB5/USBID/RB5), X8.3; also elsewhere on the board
VBUS: IC5.15 (VBUS), X4.+5V, X7.3
ZCD: IC5.16 (TDI/RPB7/CTED3/PMD5/INT0/RB7), X5.3; also elsewhere on the board

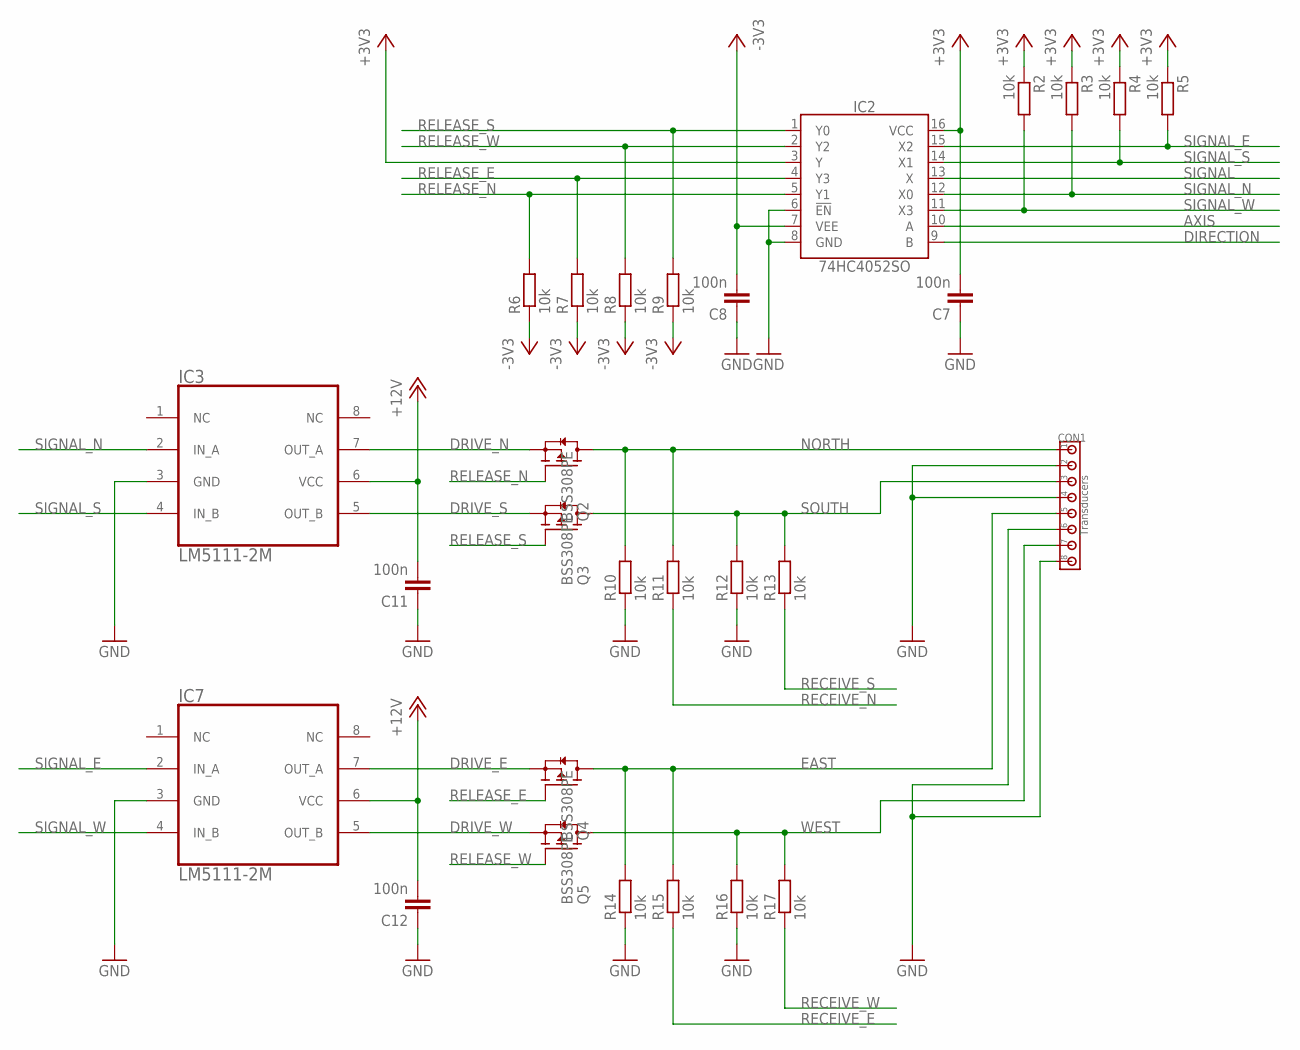
[picture p14: schematic StandaloneAnemometer_RevA.sch, sheet 2]

Parts:
C7, C8, C11, C12: 100n; C0805
CON1: Transducers; 3.5MM_8X
IC2: 74HC4052SO; SO16
IC3, IC7: LM5111-2M; SOIC8
Q2, Q3, Q4, Q5: BSS308PE; SOT23
R2, R3, R4, R5, R6, R7, R8, R9, R10, R11, R12, R13, R14, R15, R16, R17: 10k; R0805

Connections:
+3V3: C7.2, IC2.3 (Y), IC2.16 (VCC), R2.1, R3.1, R4.1, R5.1; also elsewhere on the board
+12V: C11.2, C12.2, IC3.6 (VCC), IC7.6 (VCC); also elsewhere on the board
-3V3: C8.2, IC2.7 (VEE), R6.1, R7.1, R8.1, R9.1; also elsewhere on the board
AXIS: IC2.10 (A); also elsewhere on the board
DIRECTION: IC2.9 (B); also elsewhere on the board
DRIVE_E: IC7.7 (OUT_A), Q4.2 (S)
DRIVE_N: IC3.7 (OUT_A), Q2.2 (S)
DRIVE_S: IC3.5 (OUT_B), Q3.2 (S)
DRIVE_W: IC7.5 (OUT_B), Q5.2 (S)
EAST: CON1.5, Q4.3 (D), R14.2, R15.2
GND: C7.1, C8.1, C11.1, C12.1, CON1.2, CON1.4, CON1.6, CON1.8, IC2.6 (!EN!), IC2.8 (GND), IC3.3 (GND), IC7.3 (GND), R10.1, R12.1, R14.1, R16.1; also elsewhere on the board
NORTH: CON1.1, Q2.3 (D), R10.2, R11.2
RECEIVE_E: R15.1; also elsewhere on the board
RECEIVE_N: R11.1; also elsewhere on the board
RECEIVE_S: R13.1; also elsewhere on the board
RECEIVE_W: R17.1; also elsewhere on the board
RELEASE_E: IC2.4 (Y3), Q4.1 (G), R7.2
RELEASE_N: IC2.5 (Y1), Q2.1 (G), R6.2
RELEASE_S: IC2.1 (Y0), Q3.1 (G), R9.2
RELEASE_W: IC2.2 (Y2), Q5.1 (G), R8.2
SIGNAL: IC2.13 (X); also elsewhere on the board
SIGNAL_E: IC2.15 (X2), IC7.2 (IN_A), R5.2
SIGNAL_N: IC2.12 (X0), IC3.2 (IN_A), R3.2
SIGNAL_S: IC2.14 (X1), IC3.4 (IN_B), R4.2
SIGNAL_W: IC2.11 (X3), IC7.4 (IN_B), R2.2
SOUTH: CON1.3, Q3.3 (D), R12.2, R13.2
WEST: CON1.7, Q5.3 (D), R16.2, R17.2

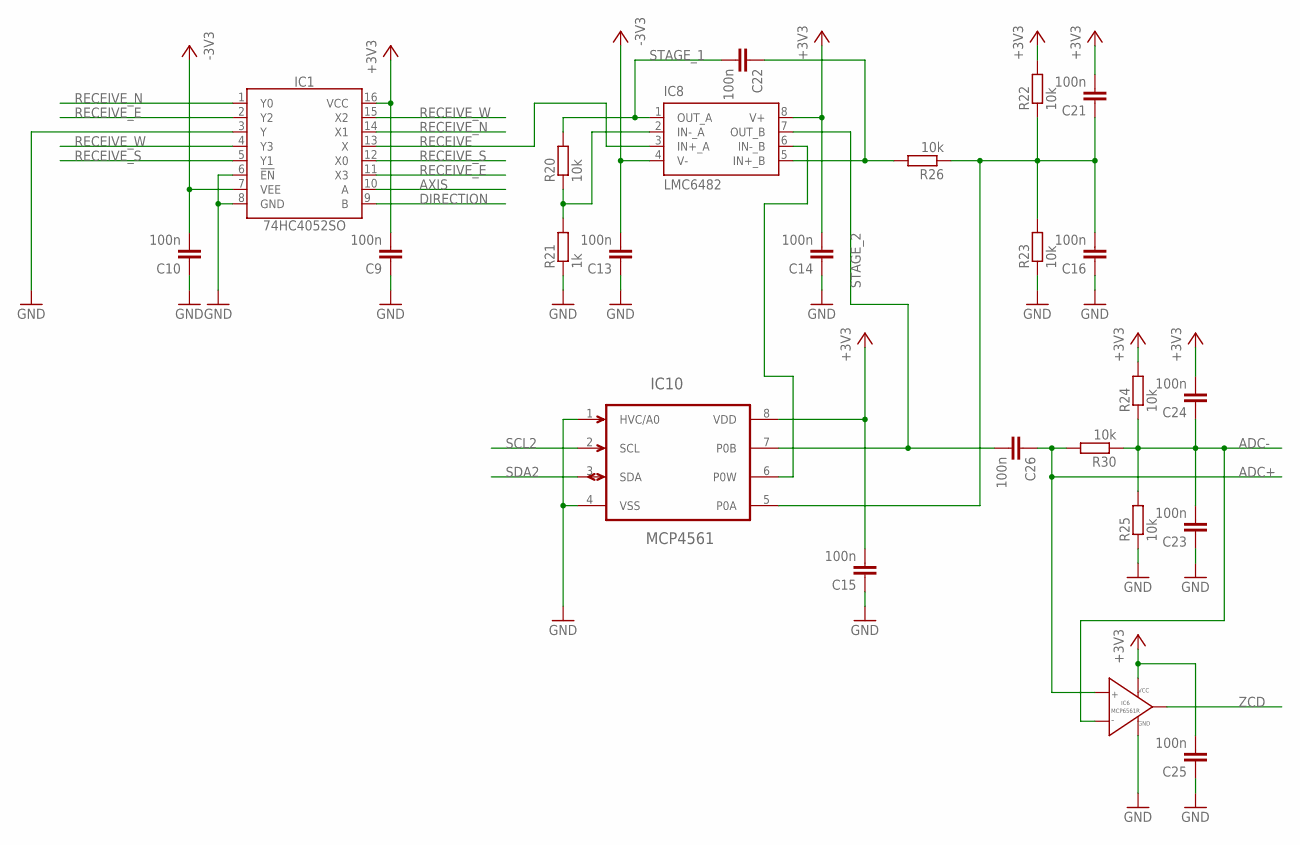
[picture p15: schematic StandaloneAnemometer_RevA.sch, sheet 3]

Parts:
C9, C10, C13, C14, C15, C16, C21, C22, C23, C24, C25, C26: 100n; C0805
IC1: 74HC4052SO; SO16
IC6: MCP6561R; SOT-23-5
IC8: LMC6482; SOIC8
IC10: MCP4561; MSOP
R20, R22, R23, R24, R25, R26, R30: 10k; R0805
R21: 1k; R0805

Connections:
+3V3: C9.2, C14.2, C15.2, C21.2, C24.2, C25.2, IC1.16 (VCC), IC6.2 (VCC), IC8.8 (V+), IC10.8 (VDD), R22.2, R24.2; also elsewhere on the board
-3V3: C10.2, C13.2, IC1.7 (VEE), IC8.4 (V-); also elsewhere on the board
ADC+: C26.1, IC6.3 (VIN+), R30.2; also elsewhere on the board
ADC-: C23.2, C24.1, IC6.4 (VIN-), R24.1, R25.2, R30.1; also elsewhere on the board
AXIS: IC1.10 (A); also elsewhere on the board
DIRECTION: IC1.9 (B); also elsewhere on the board
FB1: IC8.2 (IN-_A), R20.1, R21.2
FB2: IC8.6 (IN-_B), IC10.6 (P0W)
GND: C9.1, C10.1, C13.1, C14.1, C15.1, C16.1, C23.1, C25.1, IC1.3 (Y), IC1.6 (!EN!), IC1.8 (GND), IC6.5 (GND), IC10.1 (HVC/A0), IC10.4 (VSS), R21.1, R23.1, R25.1; also elsewhere on the board
unnamed: C16.2, C21.1, IC10.5 (P0A), R22.1, R23.2, R26.1
RECEIVE: IC1.13 (X), IC8.3 (IN+_A)
RECEIVE_E: IC1.2 (Y2), IC1.11 (X3); also elsewhere on the board
RECEIVE_N: IC1.1 (Y0), IC1.14 (X1); also elsewhere on the board
RECEIVE_S: IC1.5 (Y1), IC1.12 (X0); also elsewhere on the board
RECEIVE_W: IC1.4 (Y3), IC1.15 (X2); also elsewhere on the board
SCL2: IC10.2 (SCL); also elsewhere on the board
SDA2: IC10.3 (SDA); also elsewhere on the board
STAGE2_IN: C22.1, IC8.5 (IN+_B), R26.2
STAGE_1: C22.2, IC8.1 (OUT_A), R20.2
STAGE_2: C26.2, IC8.7 (OUT_B), IC10.7 (P0B)
ZCD: IC6.1 (VOUT); also elsewhere on the board

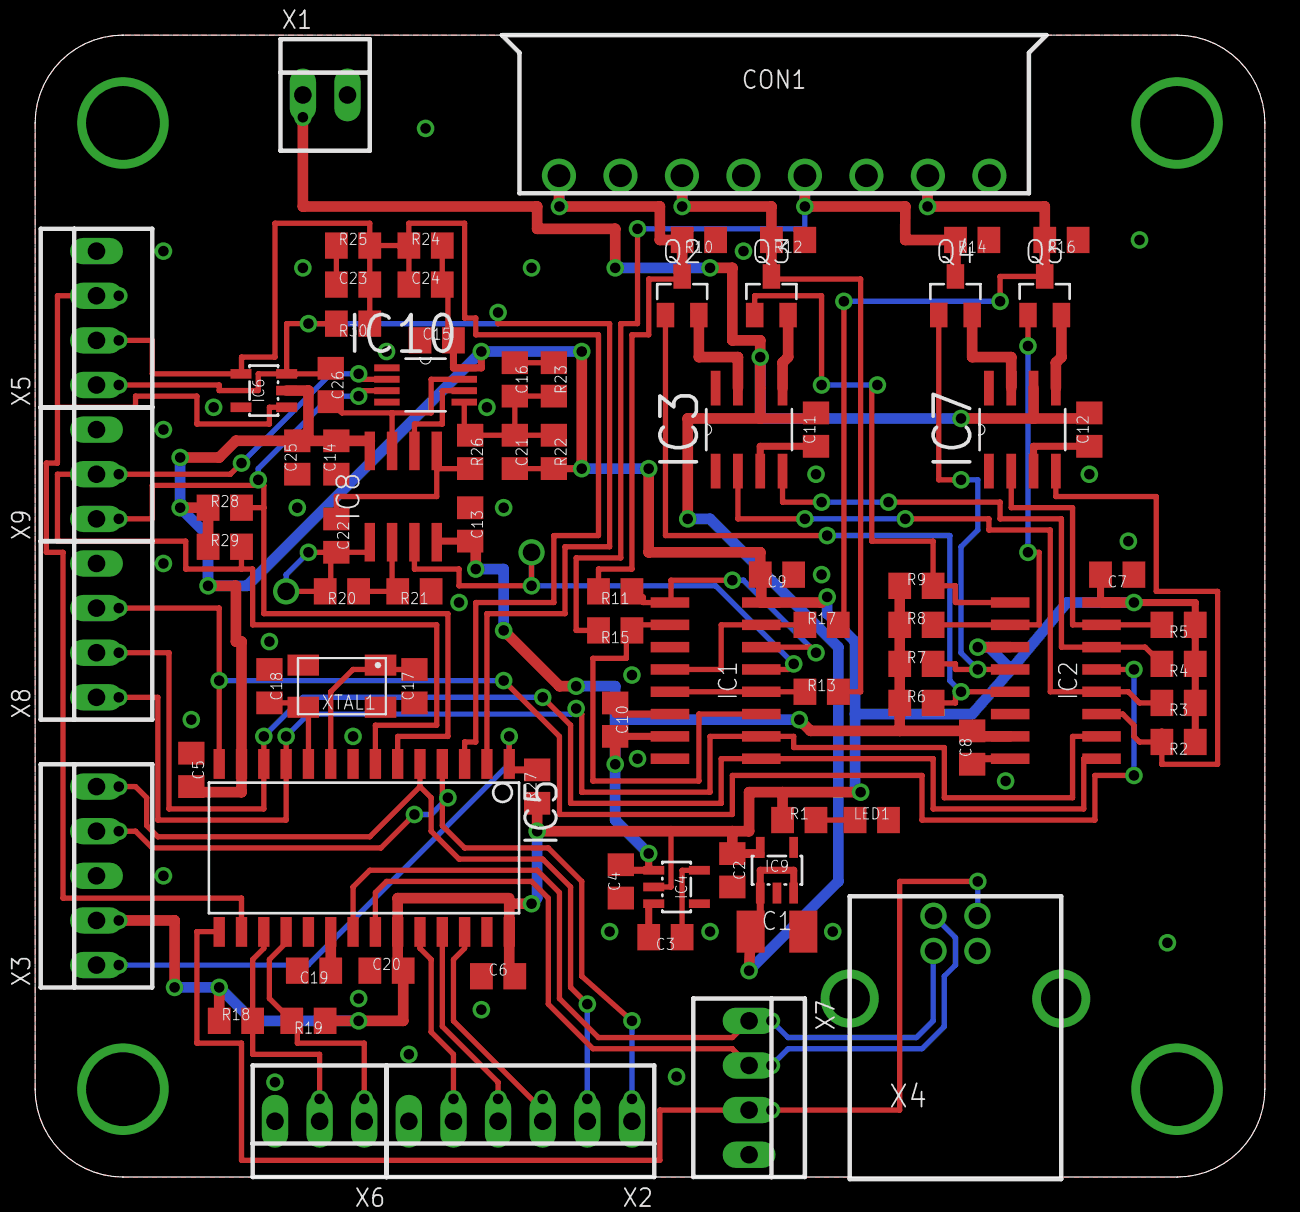
[picture p16: board StandaloneAnemometer_RevA.brd from above]

Board: 2 copper layers, 70.0 x 65.0 mm, 82 parts (0 on the bottom side), 56 nets.
